KaiBLI/EasyDABv3/Images/EasyDAB v3 Rev.7 PCB Render-Front.png

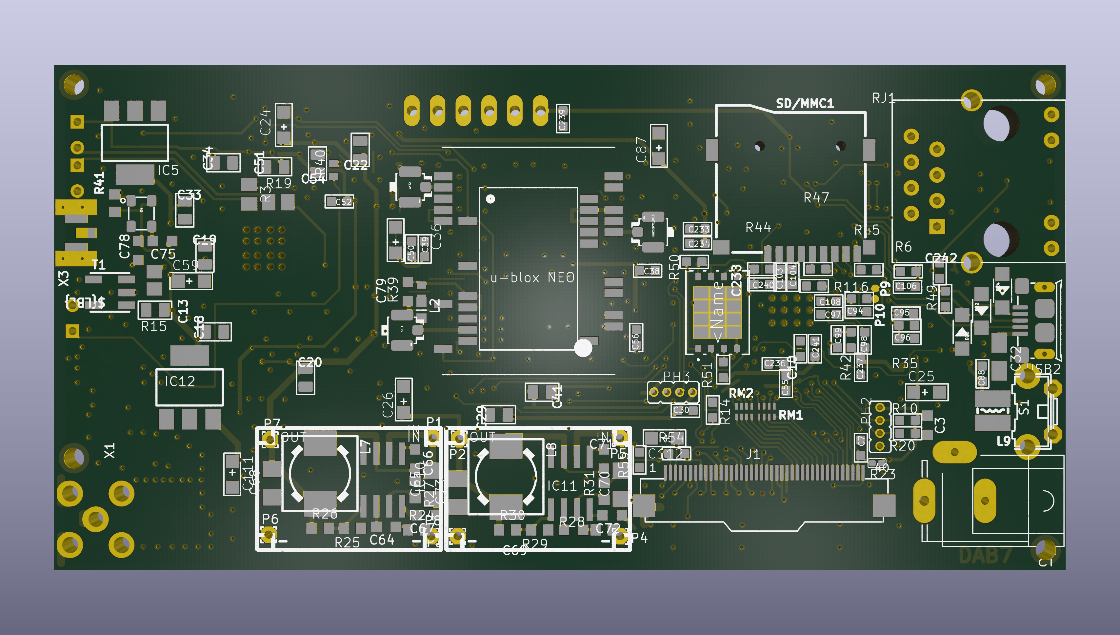
Images/EasyDAB v3 Rev.7 PCB Render-Front.png
