KaiBLI/EasyDABv3/easydabv3_big.jpg

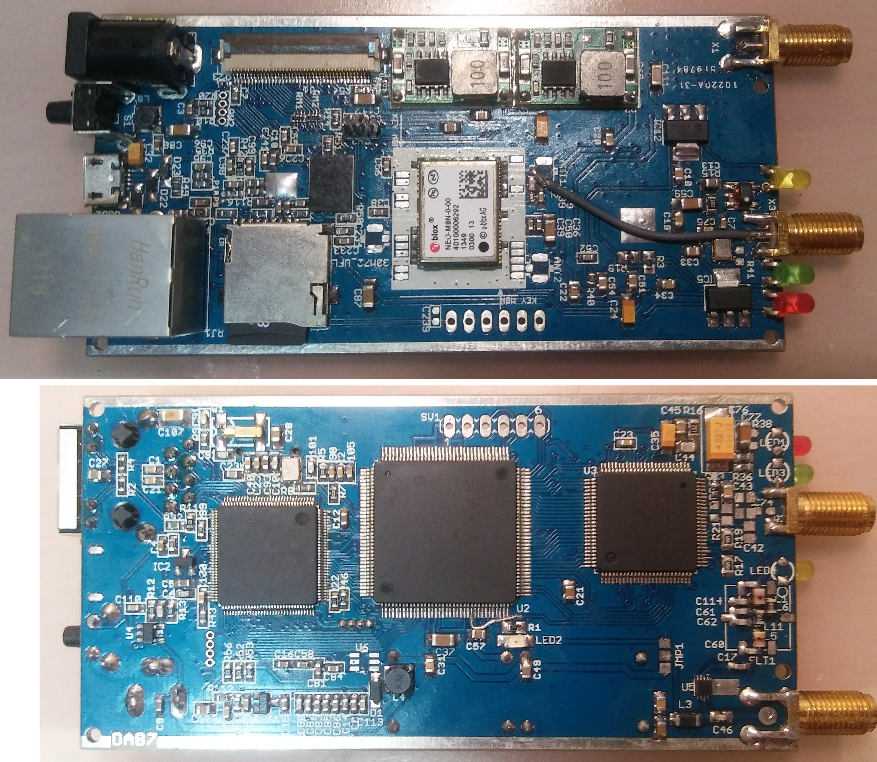
easydabv3_big.jpg
