KaiBLI/EasyDABv3/EagleBoard/V3s_LX9_AD9957_gps.brd

## EAGLE design EagleBoard/V3s_LX9_AD9957_gps.brd (2026-02-23)

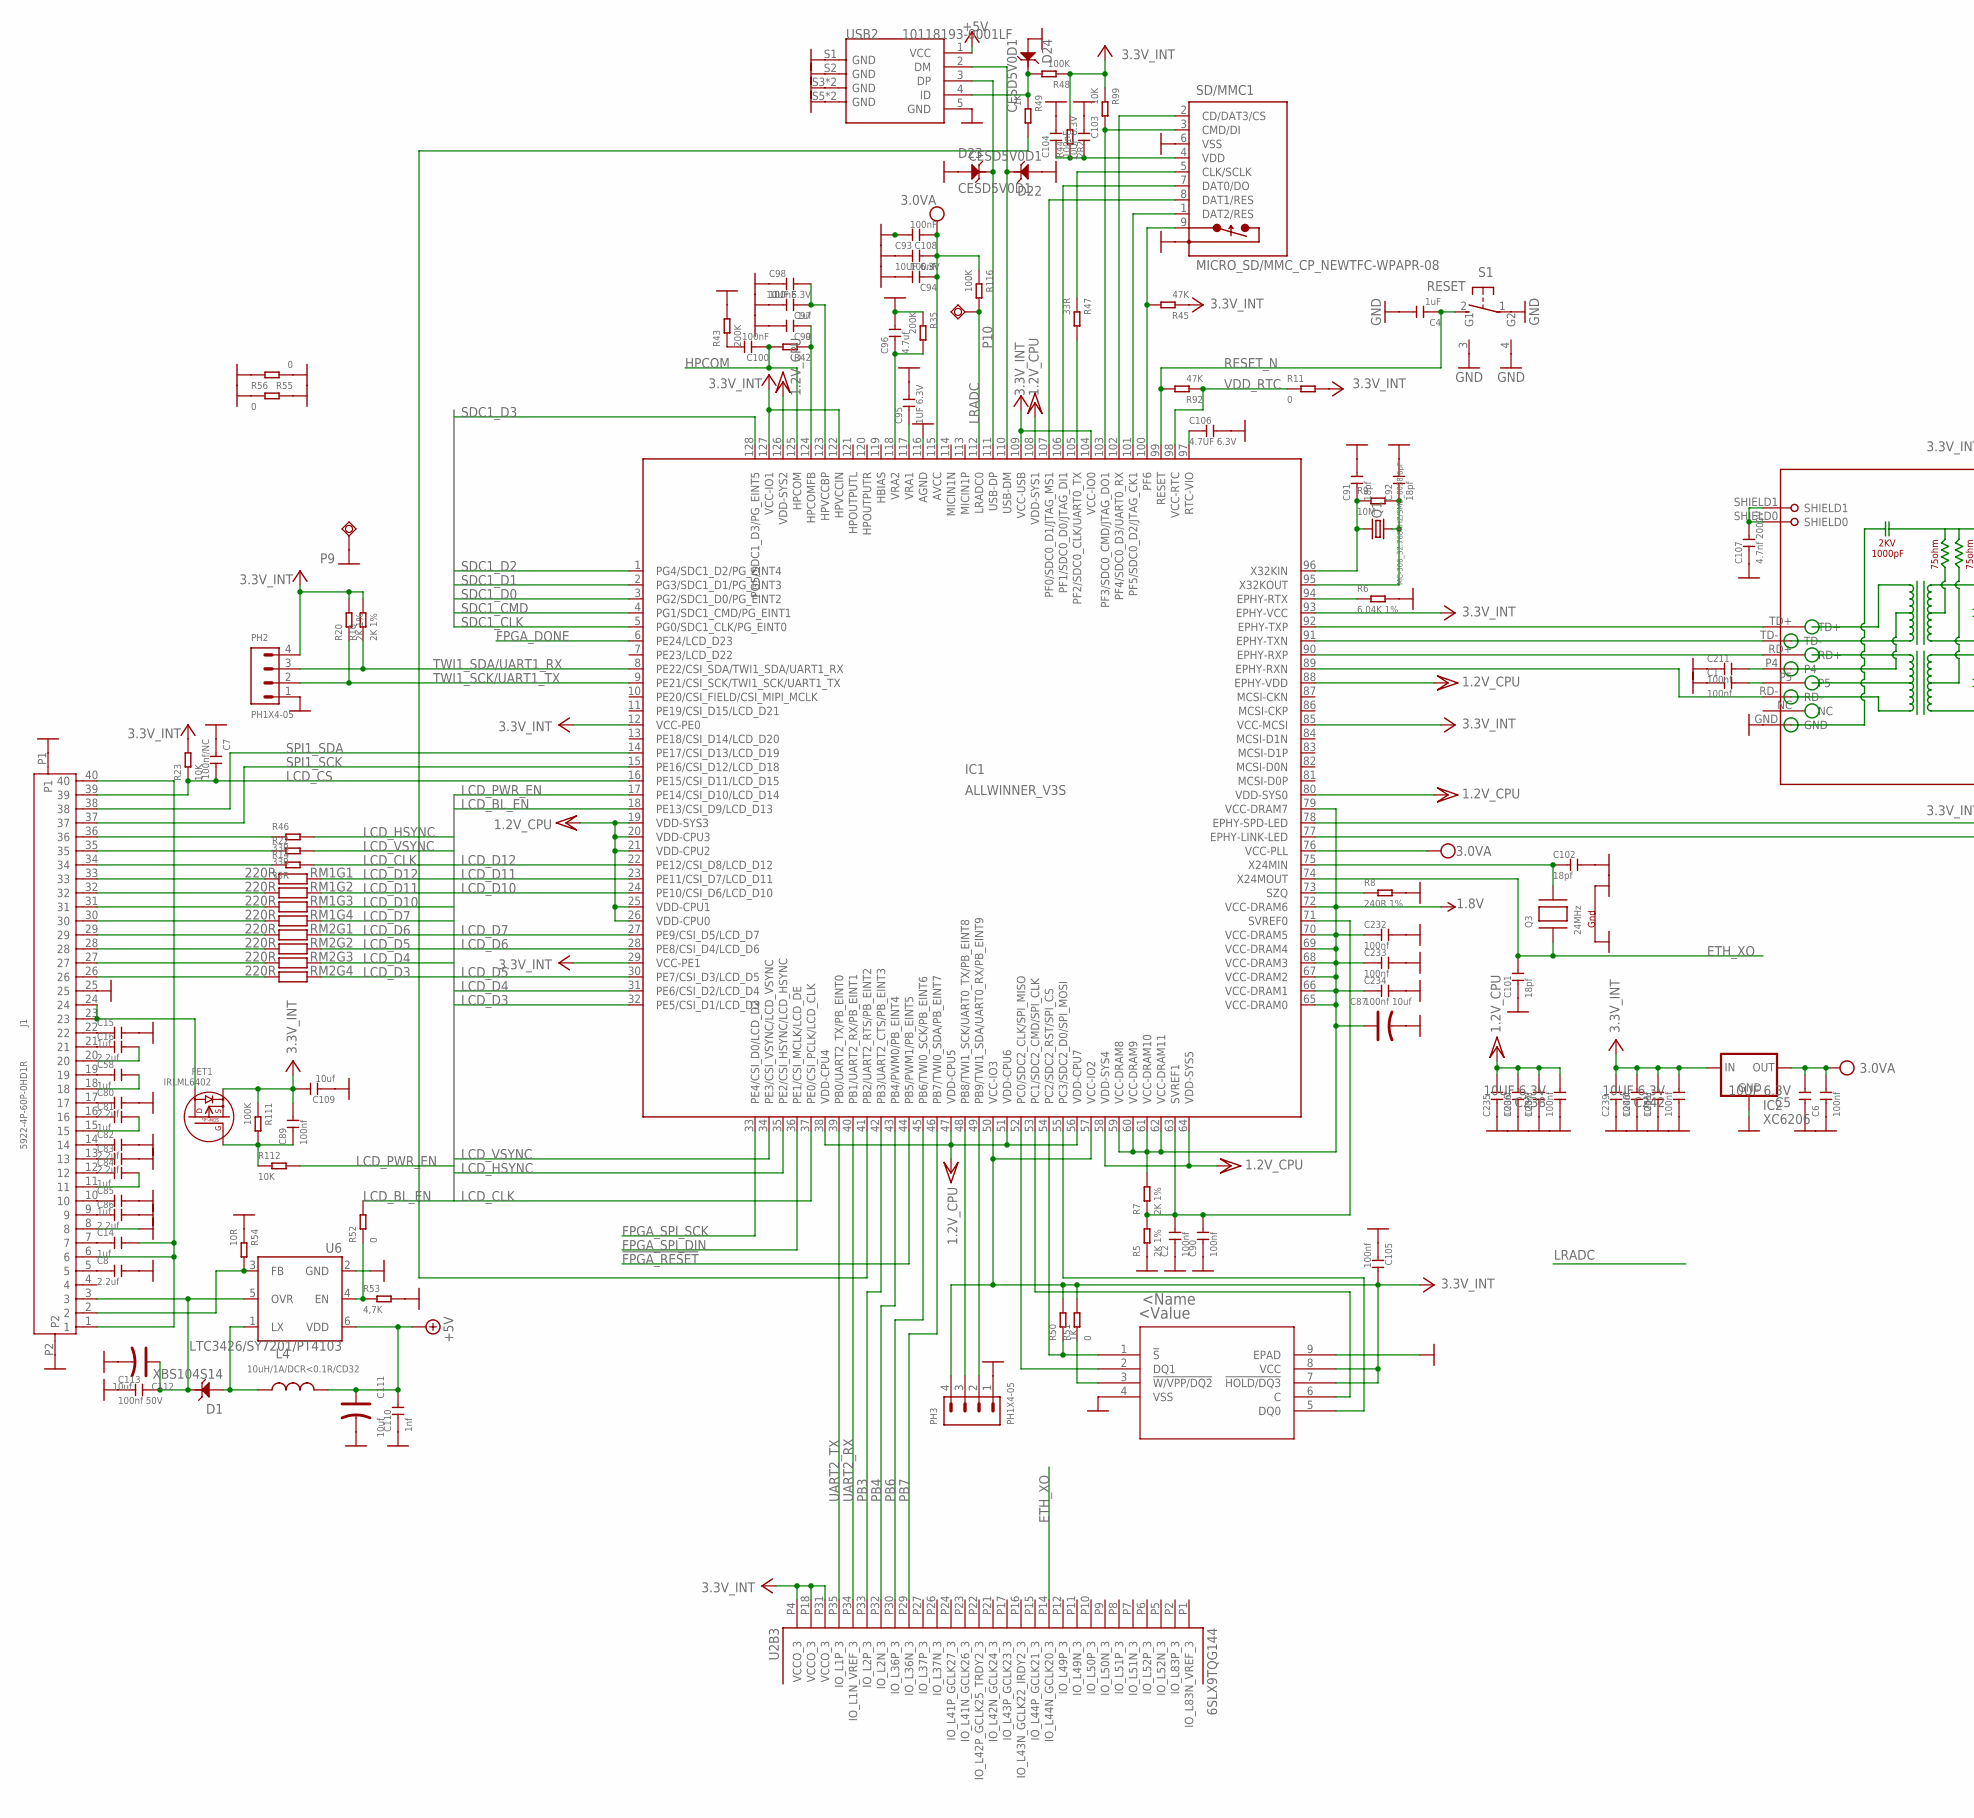
[picture p4: schematic V3s_LX9_AD9957_gps.sch, part in row 1, column 1]

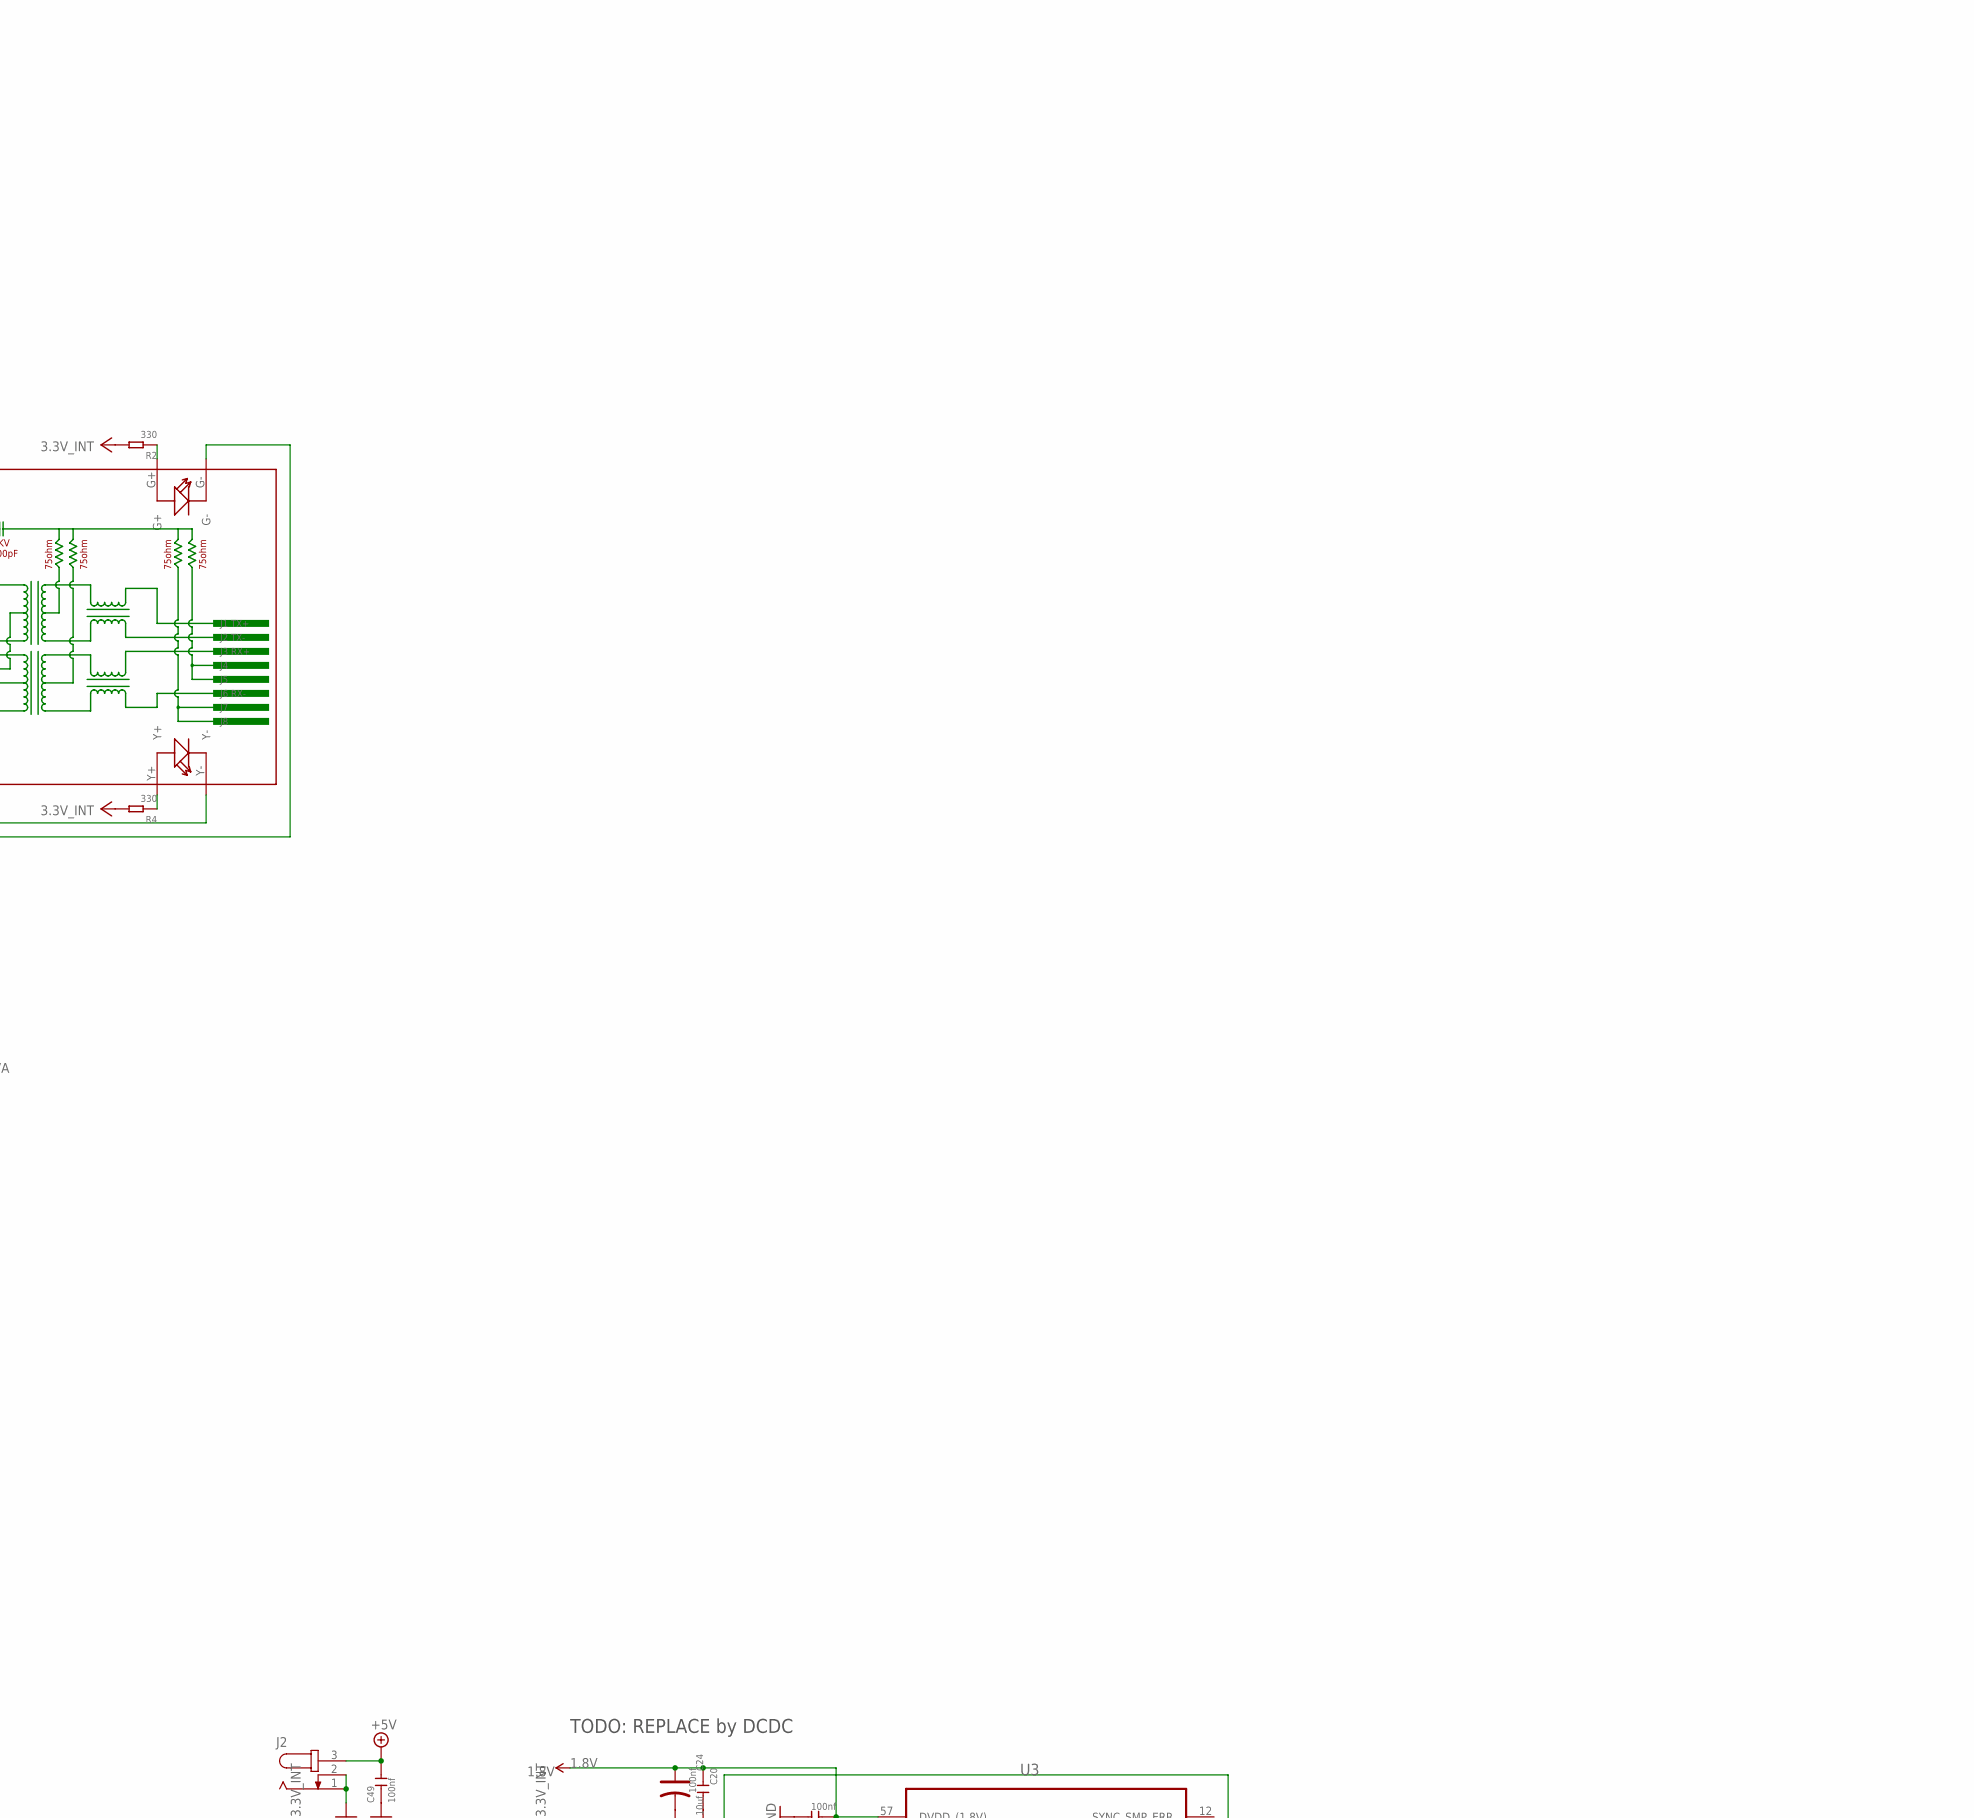
[picture p5: schematic V3s_LX9_AD9957_gps.sch, part in row 1, column 2]

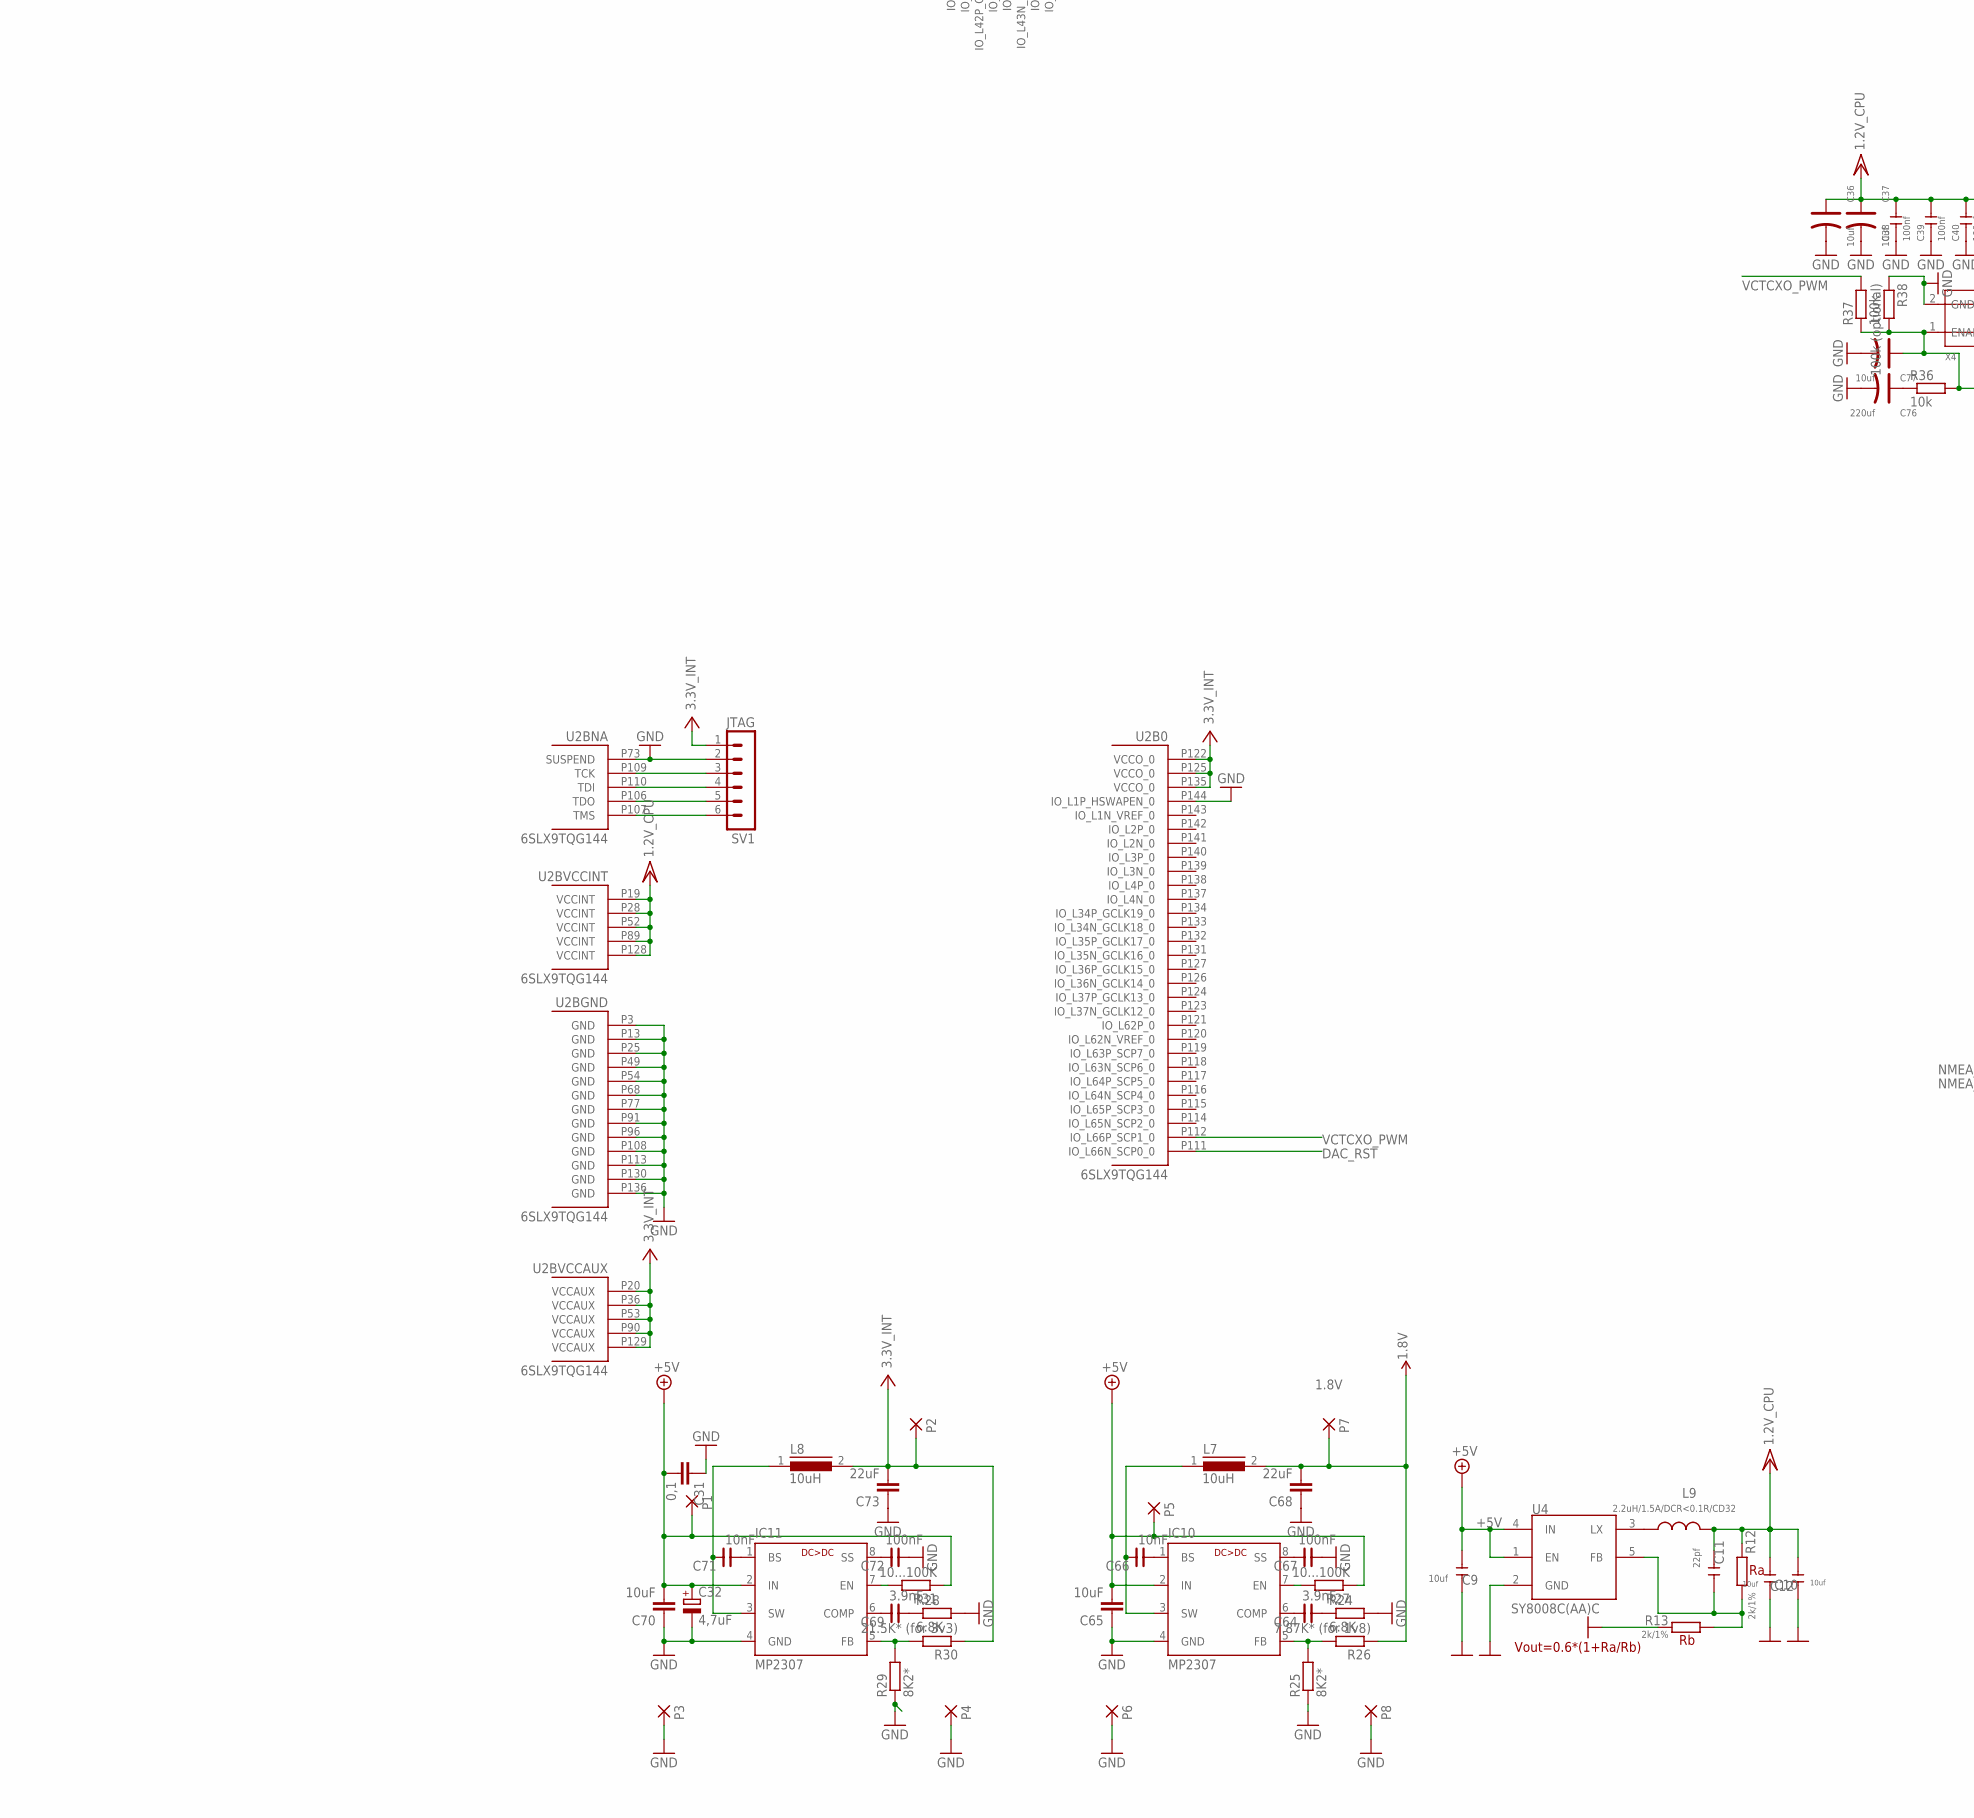
[picture p6: schematic V3s_LX9_AD9957_gps.sch, part in row 2, column 1]

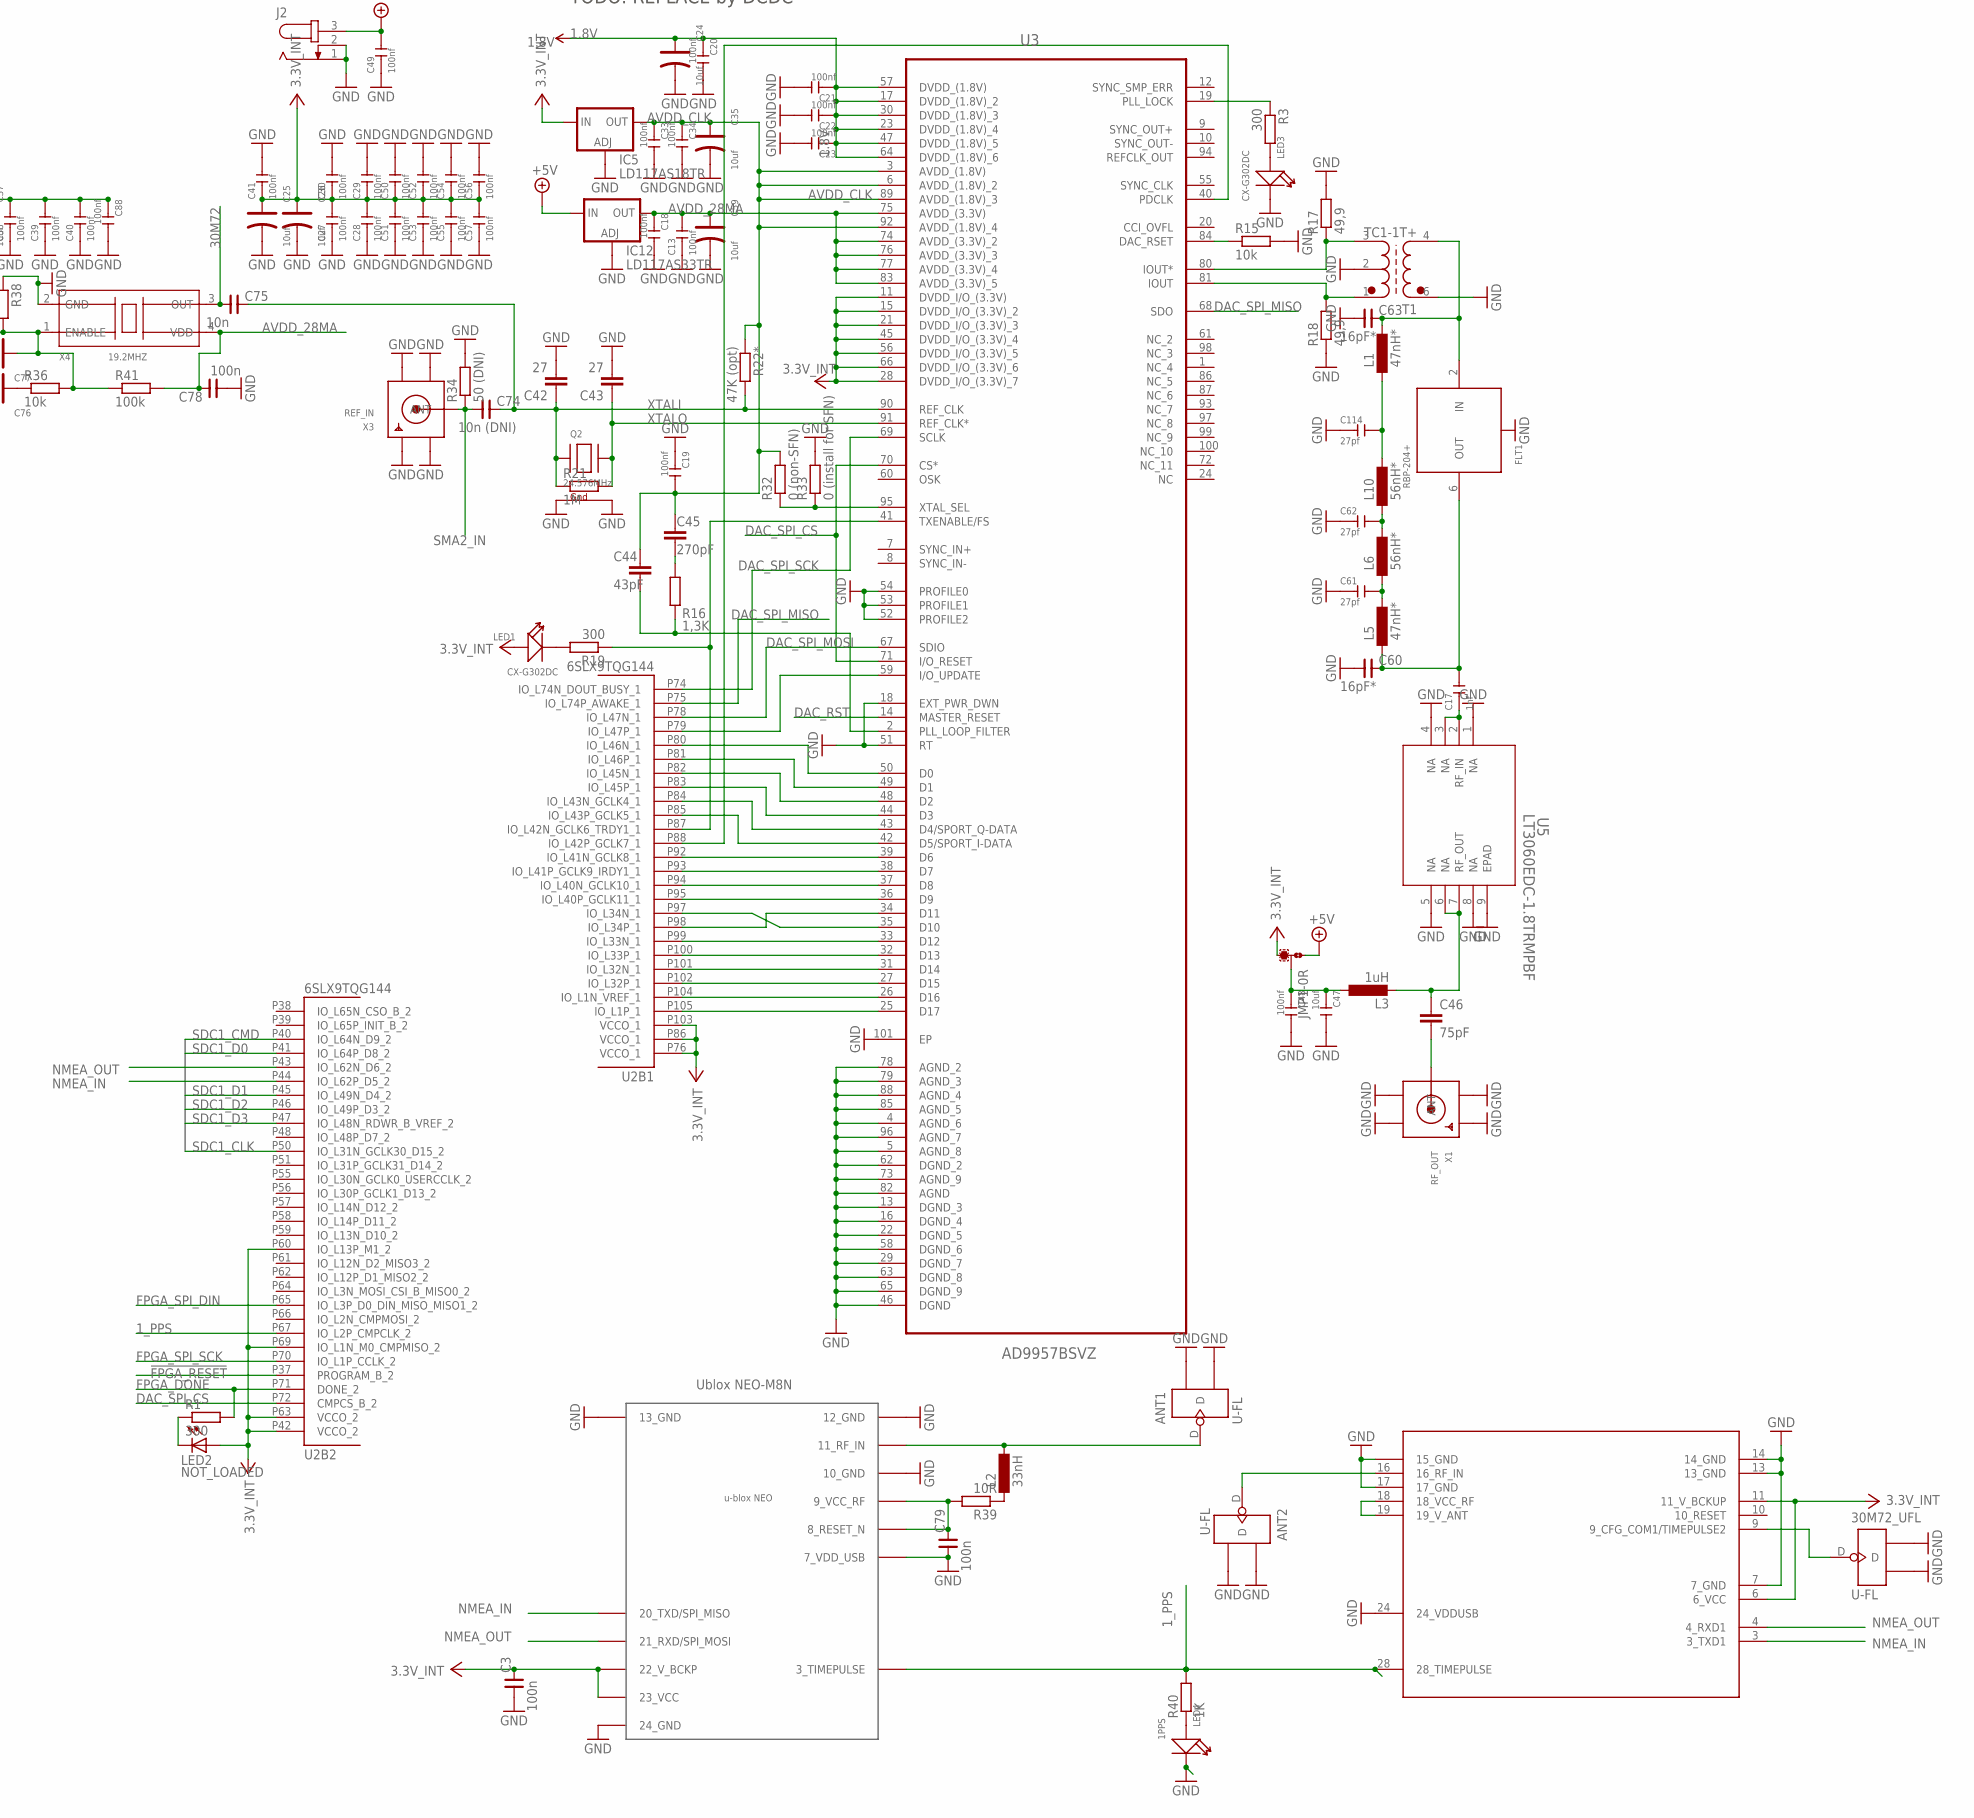
[picture p7: schematic V3s_LX9_AD9957_gps.sch, part in row 2, column 2]

Parts:
30M72_UFL: U-FL; U-FL3P-SMD-2.6X2.6X1.0MM
ANT1, ANT2: U-FL; U-FL3P-SMD-2.6X2.6X1.0MM
C1, C2, C6, C23, C30, C38, C39, C40, C50, C52, C53, C55, C56, C88, C89, C90, C105, C211, C232, C233, C234, C235, C236, C237, C239, C240, C241: 100nf; C0603
C3, C78, C79: 100n; 0603
C4: 1uF; C0603
C5, C93, C97, C103, C238, C242: 10UF 6.3V; C0603
C7: 100nf/NC; C0603
C8, C16, C80, C82, C83, C86: 2.2uf; C0603
C9, C10, C12: 10uf; C0603
C11: 22pf; C0603
C13, C18, C19, C20, C21, C22, C27, C28, C29, C33, C34, C41, C48, C49, C51, C54, C57: 100nf; C0805
C14, C15, C58, C81, C84, C85, C99: 1uf; C0603
C17, C110: 1nf; C0603
C24, C25, C26, C35, C36, C37, C59, C77, C87, C111, C112: 10uf; AVX-A
C31: 0,1; C0805
C32: 4,7uF; A/3216-18R
C42, C43: 27; C0805
C44: 43pF; C0805
C45: 270pF; C0805
C46: 75pF; C0805
C47, C109: 10uf; C0805
C60, C63: 16pF*; 0603
C61, C62, C114: 27pf; C0603
C64, C69: 3.9nF; 0603
C65, C70: 10uF; C1206
C66, C71: 10nF; 0603
C67, C72: 100nF; 0603
C68, C73: 22uF; C1206
C74: 10n (DNI); 0603
C75: 10n; 0603
C76: 220uf; AVX-D
C91, C92, C101, C102: 18pf; C0603
C94, C98, C100, C104, C108: 100nF; C0603
C95: 1UF 6.3V; C0603
C96: 4.7uf; C0603
C106: 4.7UF 6.3V; C0603
C107: 4.7nf 2000V; C1206
C113: 100nf 50V; C0603
D1: XBS104S14; SOD-123
D22, D23, D24: CESD5V0D1; SOD-123
FET1: IRLML6402; SOT23
FLT1: RBP-204+; GP731
IC1: ALLWINNER_V3S; ELQFP128
IC2: XC6206; SOT23
IC5: LD117AS18TR; SOT223
IC10, IC11: MP2307; SO8
IC12: LD117AS33TR; SOT223
J1: 5922-4P-60P-0HD1R; FPCE40-SMD-0.5-90D
J2: JACK-PLUG0; SPC4077
JMP1: 0R-JUMPA; A0R-JMP
L1, L5: 47nH*; INDC1608X95N
L2: 33nH; INDC1608X95N
L3: 1uH; L3216C
L4: 10uH/1A/DCR<0.1R/CD32; CD32
L6, L10: 56nH*; INDC1608X95N
L7, L8: 10uH; DR74
L9: 2.2uH/1.5A/DCR<0.1R/CD32; CD32
LED1, LED3: CX-G302DC; LED2-2.54-D3.0MM
LED2: NOT_LOADED; CHIPLED_1206
LED4: 1PPS; LED2-2.54-D3.0MM
P1, P2, P3, P4, P5, P6, P7, P8: 1,6/0,8
P9, P10: TESTPADTESTPAD30/30; TESTPAD_30-ROUND
PH2, PH3: PH1X4-05; PH005-1-4
Q1: MC-306_32.768KHZ/SMD_8038/6pF; MC-306
Q2: 24.576MHz; NX3225
Q3: 24MHz; NX3225
R1, R3, R19: 300; M0805
R2, R4: 330; R0603
R5, R7, R10, R20: 2K 1%; R0603
R6: 6.04K 1%; R0603
R8: 240R 1%; R0603
R9: 10M; R0603
R11, R42, R51, R52, R55, R56: 0; R0603
R12, R13: 2k/1%; R0603_5MIL_DWS
R14, R22, R46, R47: 33R; R0603
R15: 10k; R0805
R16: 1,3K; R0805
R17, R18: 49,9; R0805
R21: 1M; R0805
R22*: 47K (opt); R0603
R23: 10K; R0402
R24, R28: 6.8K; R0603
R25, R29: 8K2*; R0603
R26: 7.87K* (for 1v8); R0603
R27, R31: 10...100K; R0603
R30: 21.5K* (for 3v3); R0603
R32: 0 (non-SFN); R0402
R33: 0 (install for SFN); R0402
R34: 50 (DNI); R0402
R35, R43: 200K; R0603
R36: 10k; R0603
R37, R41: 100k; R0603
R38: 100k (optional); R0603
R39: 10R; R0402
R40: 1K; R0402
R44: 2R2; R0603
R45, R92: 47K; R0603
R48, R111, R116: 100K; R0603
R49, R50: 1K; R0603
R53: 4,7K; R0603
R54: 10R; R0603
R99, R112: 10K; R0603
RJ1: HR911105A
RM1, RM2: 220R; R_MATRIX_4_0402_25X625
S1: RESET; B3F-31XX
SD/MMC1: MICRO_SD/MMC_CP_NEWTFC-WPAPR-08; TFC-WPAPR-08
SV1: JTAG; MA06-1
T1: TC1-1T+; AT224-3
U1: N25Q256A13EF840EMIC; MIC-VFDFPN-8_8X6-M
U2: 6SLX9TQG144; TQ144
U3: AD9957BSVZ; QFP50P1600X1600X120-101N
U4: SY8008C(AA)C; SOT23-5
U5: LT3060EDC-1.8TRMPBF; DFN-8_DC
U6: LTC3426/SY7201/PT4103; SOT23-6
U10: NEO-M8
U11: UBLOX_LEA-6; UBLOX_LEA-6T
USB2: 10118193-0001LF; MICRO-USB5+6P-SMD-0.65-B
X1: RF_OUT; SMA90_DIP
X3: REF_IN; W5500_LX9_AD9957_SMA_EDGELAUNCH_UFL
X4: 19.2MHZ; X4-SMD-3.2X2.5X0.7MM

Connections:
1.8V: C20.1, C21.1, C22.1, C23.1, C24.+, C68.2, C87.+, C232.1, C233.1, C234.1, IC1.59 (VCC-DRAM8), IC1.60 (VCC-DRAM9), IC1.61 (VCC-DRAM10), IC1.62 (VCC-DRAM11), IC1.65 (VCC-DRAM0), IC1.66 (VCC-DRAM1), IC1.67 (VCC-DRAM2), IC1.68 (VCC-DRAM3), IC1.69 (VCC-DRAM4), IC1.70 (VCC-DRAM5), IC1.72 (VCC-DRAM6), IC1.79 (VCC-DRAM7), L7.2, P7.1, R7.2, R26.1, U3.17 (DVDD_(1.8V)_2), U3.23 (DVDD_(1.8V)_4), U3.30 (DVDD_(1.8V)_3), U3.47 (DVDD_(1.8V)_5), U3.57 (DVDD_(1.8V)), U3.64 (DVDD_(1.8V)_6)
1_PPS: R40.2, U2.P67 (IO_L2P_CMPCLK_2), U10.3 (3_TIMEPULSE), U11.28 (28_TIMEPULSE)
30M72: C75.1, X4.3 (OUT)
!FPGA_RESET: IC1.44 (PB5/PWM1/PB_EINT5), U2.P37 (PROGRAM_B_2)
+5V: C9.1, C31.2, C32.+, C49.2, C65.2, C70.2, C110.2, C111.+, IC10.2 (IN), IC11.2 (IN), IC12.3 (IN), J2.3, JMP1.1, L4.1, P1.1, P5.1, R27.1, R31.1, U4.1 (EN), U4.4 (IN), U6.6 (VDD), USB2.1 (VCC)
AVDD_28MA: C13.2, C18.1, C59.+, C78.2, IC12.4 (OUT), R41.2, U3.74 (AVDD_(3.3V)_2), U3.75 (AVDD_(3.3V)), U3.76 (AVDD_(3.3V)_3), U3.77 (AVDD_(3.3V)_4), U3.83 (AVDD_(3.3V)_5), X4.4 (VDD)
AVDD_CLK: C19.2, C33.1, C34.1, C35.+, C44.1, C45.1, IC5.4 (OUT), R22*.1, R32.2, U3.3 (AVDD_(1.8V)), U3.6 (AVDD_(1.8V)_2), U3.89 (AVDD_(1.8V)_3), U3.92 (AVDD_(1.8V)_4)
DAC_RST: U2.P111 (IO_L66N_SCP0_0), U3.14 (MASTER_RESET)
DAC_SPI_CS: U2.P72 (CMPCS_B_2), U3.70 (CS*), U3.71 (I/O_RESET)
DAC_SPI_MISO: U2.P75 (IO_L74P_AWAKE_1), U3.68 (SDO)
DAC_SPI_MOSI: U2.P78 (IO_L47N_1), U3.67 (SDIO)
DAC_SPI_SCK: U2.P74 (IO_L74N_DOUT_BUSY_1), U3.69 (SCLK)
ETH_XO: C101.2, IC1.74 (X24MOUT), Q3.1 (X1), U2.P14 (IO_L44N_GCLK20_3)
FPGA_DONE: IC1.6 (PE24/LCD_D23), R1.2, U2.P71 (DONE_2)
FPGA_SPI_DIN: IC1.36 (PE1/CSI_MCLK/LCD_DE), U2.P65 (IO_L3P_D0_DIN_MISO_MISO1_2)
FPGA_SPI_SCK: IC1.33 (PE4/CSI_D0/LCD_D2), U2.P70 (IO_L1P_CCLK_2)
GND: 30M72_UFL.GND1, 30M72_UFL.GND2, ANT1.GND1, ANT1.GND2, ANT2.GND1, ANT2.GND2, C1.1, C2.1, C3.1, C4.2, C5.1, C6.1, C7.1, C8.2, C9.2, C10.2, C12.2, C13.1, C15.2, C18.2, C19.1, C20.2, C21.2, C22.2, C23.2, C24.-, C25.-, C26.-, C27.1, C28.1, C29.2, C30.2, C31.1, C32.-, C33.2, C34.2, C35.-, C36.-, C37.-, C38.1, C39.1, C40.1, C41.2, C42.2, C43.2, C47.2, C48.2, C49.1, C50.2, C51.1, C52.2, C53.1, C54.2, C55.1, C56.2, C57.1, C59.-, C60.1, C61.1, C62.1, C63.1, C65.1, C67.1, C68.1, C70.1, C72.1, C73.1, C76.-, C77.-, C78.1, C79.1, C80.2, C82.2, C83.2, C85.2, C86.2, C87.-, C88.2, C90.1, C91.2, C92.2, C93.1, C94.2, C95.2, C96.2, C97.2, C98.1, C99.2, C101.1, C102.2, C103.1, C104.2, C105.1, C106.2, C107.1, C108.2, C109.1, C110.1, C111.-, C112.-, C113.1, C114.1, C211.1, C232.2, C233.2, C234.2, C235.1, C236.1, C237.1, C238.1, C239.1, C240.1, C241.1, C242.1, D22.+ (1), D23.+ (1), D24.+ (1), FLT1.1 (GND), FLT1.3 (GND), FLT1.4 (GND), FLT1.5 (GND), FLT1.7 (GND), FLT1.8 (GND), IC1.116 (AGND), IC2.1 (GND), IC5.1 (ADJ), IC10.4 (GND), IC11.4 (GND), IC12.1 (ADJ), J1.8, J1.25, J1.P1, J1.P2, J2.1, J2.2, LED3.K (-), LED4.K (-), P3.1, P4.1, P6.1, P8.1, P9.1, PH2.1, PH3.1, Q2.2 (G2), Q2.4 (G1), Q3.2 (G2), Q3.4 (G1), R5.1, R6.2, R8.2, R13.2, R15.2, R17.2, R18.1, R24.2, R25.1, R28.2, R29.1, R33.2, R34.2, R35.1, R38.1, R43.2, R53.2, R54.1, R55.1, R55.2, R56.1, R56.2, RJ1.GND, S1.1, S1.3 (G1), S1.4 (G2), SD/MMC1.6 (VSS), SD/MMC1.10 (PACK1), SV1.2, T1.2 (SCT), T1.6 (PD), U1.4 (VSS), U1.9 (EPAD), U2.P3 (GND), U2.P13 (GND), U2.P25 (GND), U2.P49 (GND), U2.P54 (GND), U2.P68 (GND), U2.P73 (SUSPEND), U2.P77 (GND), U2.P91 (GND), U2.P96 (GND), U2.P108 (GND), U2.P113 (GND), U2.P130 (GND), U2.P136 (GND), U2.P144 (IO_L1P_HSWAPEN_0), U3.4 (AGND_6), U3.5 (AGND_8), U3.13 (DGND_3), U3.16 (DGND_4), U3.18 (EXT_PWR_DWN), U3.22 (DGND_5), U3.29 (DGND_7), U3.46 (DGND), U3.51 (RT), U3.52 (PROFILE2), U3.53 (PROFILE1), U3.54 (PROFILE0), U3.58 (DGND_6), U3.62 (DGND_2), U3.63 (DGND_8), U3.65 (DGND_9), U3.73 (AGND_9), U3.78 (AGND_2), U3.79 (AGND_3), U3.82 (AGND), U3.85 (AGND_5), U3.88 (AGND_4), U3.96 (AGND_7), U3.101 (EP), U4.2 (GND), U5.1 (NA), U5.4 (NA), U5.5 (NA), U5.8 (NA), U5.9 (EPAD), U6.2 (GND), U10.7 (7_VDD_USB), U10.10 (10_GND), U10.12 (12_GND), U10.13 (13_GND), U10.24 (24_GND), U11.7 (7_GND), U11.13 (13_GND), U11.14 (14_GND), U11.15 (15_GND), U11.17 (17_GND), U11.24 (24_VDDUSB), USB2.5 (GND), USB2.S1 (GND), USB2.S2 (GND), USB2.S3 (GND), USB2.S4 (GND), USB2.S5 (GND), USB2.S6 (GND), X1.GND1, X1.GND2, X1.GND3, X1.GND4, X3.GND@1 (GND1), X3.GND@2 (GND2), X3.GND@3 (GND3), X3.GND@4 (GND4), X4.2 (GND)
GPSDO_OUT_30M72: 30M72_UFL.D, U11.9 (9_CFG_COM1/TIMEPULSE2)
HPCOM: C100.1, IC1.125 (HPCOM), R42.2
LCD_BL_EN: IC1.18 (PE13/CSI_D9/LCD_D13), R52.2
LCD_CLK: IC1.37 (PE0/CSI_PCLK/LCD_CLK), R14.2
LCD_CS: C7.2, IC1.16 (PE15/CSI_D11/LCD_D15), J1.39, R23.1
LCD_D3: IC1.32 (PE5/CSI_D1/LCD_D3), RM2.4.1 (1)
LCD_D4: IC1.31 (PE6/CSI_D2/LCD_D4), RM2.3.1 (1)
LCD_D5: IC1.30 (PE7/CSI_D3/LCD_D5), RM2.2.1 (1)
LCD_D6: IC1.28 (PE8/CSI_D4/LCD_D6), RM2.1.1 (1)
LCD_D7: IC1.27 (PE9/CSI_D5/LCD_D7), RM1.4.1 (1)
LCD_D10: IC1.24 (PE10/CSI_D6/LCD_D10), RM1.3.1 (1)
LCD_D11: IC1.23 (PE11/CSI_D7/LCD_D11), RM1.2.1 (1)
LCD_D12: IC1.22 (PE12/CSI_D8/LCD_D12), RM1.1.1 (1)
LCD_HSYNC: IC1.35 (PE2/CSI_HSYNC/LCD_HSYNC), R46.2
LCD_PWR_EN: IC1.17 (PE14/CSI_D10/LCD_D14), R112.2
LCD_VSYNC: IC1.34 (PE3/CSI_VSYNC/LCD_VSYNC), R22.2
LRADC: IC1.112 (LRADC0), P10.1, R116.2
unnamed: SV1.6, U2.P107 (TMS)
unnamed: SV1.5, U2.P106 (TDO)
unnamed: SV1.4, U2.P110 (TDI)
unnamed: SV1.3, U2.P109 (TCK)
unnamed: LED2.C, R1.1
unnamed: C62.2, L6.2, L10.1
unnamed: U2.P105 (IO_L1P_1), U3.25 (D17)
unnamed: C14.2, J1.1, J1.6, J1.40
unnamed: U2.P88 (IO_L42P_GCLK7_1), U3.40 (PDCLK)
unnamed: R19.1, U2.P87 (IO_L42N_GCLK6_TRDY1_1), U3.41 (TXENABLE/FS)
unnamed: U2.P85 (IO_L43P_GCLK5_1), U3.42 (D5/SPORT_I-DATA)
unnamed: U2.P84 (IO_L43N_GCLK4_1), U3.43 (D4/SPORT_Q-DATA)
unnamed: U2.P83 (IO_L45P_1), U3.44 (D3)
unnamed: U2.P82 (IO_L45N_1), U3.48 (D2)
unnamed: U2.P92 (IO_L41N_GCLK8_1), U3.39 (D6)
unnamed: U2.P93 (IO_L41P_GCLK9_IRDY1_1), U3.38 (D7)
unnamed: U2.P94 (IO_L40N_GCLK10_1), U3.37 (D8)
unnamed: U2.P95 (IO_L40P_GCLK11_1), U3.36 (D9)
unnamed: U2.P98 (IO_L34P_1), U3.34 (D11)
unnamed: U2.P97 (IO_L34N_1), U3.35 (D10)
unnamed: U2.P99 (IO_L33N_1), U3.33 (D12)
unnamed: U2.P100 (IO_L33P_1), U3.32 (D13)
unnamed: U2.P101 (IO_L32N_1), U3.31 (D14)
unnamed: U2.P102 (IO_L32P_1), U3.27 (D15)
unnamed: U2.P104 (IO_L1N_VREF_1), U3.26 (D16)
unnamed: U2.P79 (IO_L47P_1), U3.59 (I/O_UPDATE)
unnamed: C14.1, J1.7
unnamed: U2.P81 (IO_L46P_1), U3.49 (D1)
unnamed: LED3.A (+), R3.2
unnamed: R3.1, U3.19 (PLL_LOCK)
unnamed: R15.1, U3.84 (DAC_RSET)
unnamed: R17.1, T1.3 (S), U3.80 (IOUT*)
unnamed: R18.2, T1.1 (SD), U3.81 (IOUT)
unnamed: C63.2, FLT1.2 (IN), L1.2, T1.4
unnamed: U2.P80 (IO_L46N_1), U3.50 (D0)
unnamed: IC1.89 (EPHY-RXN), RJ1.RD-
unnamed: C211.2, RJ1.P4
unnamed: IC1.94 (EPHY-RTX), R6.1
unnamed: IC1.78 (EPHY-SPD-LED), RJ1.Y-
unnamed: IC1.77 (EPHY-LINK-LED), RJ1.G-
unnamed: R4.1, RJ1.Y+
unnamed: R2.1, RJ1.G+
unnamed: C2.2, C90.2, IC1.63 (SVREF1), IC1.71 (SVREF0), R5.2, R7.1
unnamed: IC1.73 (SZQ), R8.1
unnamed: C92.1, IC1.95 (X32KOUT), Q1.1, R9.2
unnamed: C91.1, IC1.96 (X32KIN), Q1.4 (2), R9.1
unnamed: D22.- (2), IC1.110 (USB-DM), USB2.2 (DM)
unnamed: D23.- (2), IC1.111 (USB-DP), USB2.3 (DP)
unnamed: C95.1, IC1.117 (VRA1)
unnamed: C96.1, IC1.118 (VRA2), R35.2
unnamed: C99.1, IC1.124 (HPCOMFB), R42.1
unnamed: C102.1, IC1.75 (X24MIN), Q3.3 (X2)
unnamed: U11.18 (18_VCC_RF), U11.19 (19_V_ANT)
unnamed: IC1.107 (PF0/SDC0_D1/JTAG_MS1), SD/MMC1.8 (DAT1/RES)
unnamed: IC1.106 (PF1/SDC0_D0/JTAG_DI1), SD/MMC1.7 (DAT0/DO)
unnamed: R47.1, SD/MMC1.5 (CLK/SCLK)
unnamed: IC1.103 (PF3/SDC0_CMD/JTAG_DO1), R99.2, SD/MMC1.3 (CMD/DI)
unnamed: IC1.102 (PF4/SDC0_D3/UART0_RX), SD/MMC1.2 (CD/DAT3/CS)
unnamed: IC1.101 (PF5/SDC0_D2/JTAG_CK1), SD/MMC1.1 (DAT2/RES)
unnamed: IC1.100 (PF6), R45.2, SD/MMC1.9 (CP_E)
unnamed: ANT1.D, L2.2, U10.11 (11_RF_IN)
unnamed: IC1.105 (PF2/SDC0_CLK/UART0_TX), R47.2
unnamed: D24.- (2), R48.2, R49.1, USB2.4 (ID)
unnamed: IC1.41 (PB2/UART2_RTS/PB_EINT2), R49.2
unnamed: IC1.92 (EPHY-TXP), RJ1.TD+
unnamed: IC1.91 (EPHY-TXN), RJ1.TD-
unnamed: IC1.90 (EPHY-RXP), RJ1.RD+
unnamed: L9.1, U4.3 (LX)
unnamed: C97.1, C98.2, IC1.123 (HPVCCBP)
unnamed: C8.1, J1.5
unnamed: R51.1, U1.3 (!W/VPP/DQ2)
unnamed: C11.2, R12.2, R13.1, U4.5 (FB)
unnamed: J1.33, RM1.1.2 (2)
unnamed: ANT2.D, U11.16 (16_RF_IN)
unnamed: C114.2, L1.1, L10.2
unnamed: C44.2, R16.2, U3.2 (PLL_LOOP_FILTER)
unnamed: J1.36, R46.1
unnamed: J1.35, R22.1
unnamed: J1.34, R14.1
unnamed: J1.32, RM1.2.2 (2)
unnamed: J1.31, RM1.3.2 (2)
unnamed: J1.30, RM1.4.2 (2)
unnamed: C45.2, R16.1
unnamed: C17.2, C60.2, FLT1.6 (OUT), L5.1
unnamed: J1.29, RM2.1.2 (2)
unnamed: C46.1, L3.2, U5.6 (NA), U5.7 (RF_OUT)
unnamed: C46.2, X1.ANTENNA (ANT)
unnamed: C47.1, C48.1, JMP1.2, L3.1
unnamed: LED1.K (-), R19.2
unnamed: L2.1, R39.1
unnamed: C61.2, L5.2, L6.1
unnamed: J1.28, RM2.2.2 (2)
unnamed: C79.2, R39.2, U10.8 (8_RESET_N), U10.9 (9_VCC_RF)
unnamed: LED4.A (+), R40.1
unnamed: J1.27, RM2.3.2 (2)
unnamed: J1.26, RM2.4.2 (2)
unnamed: C15.1, J1.22
unnamed: C17.1, U5.2 (RF_IN), U5.3 (NA)
unnamed: C64.2, IC10.6 (COMP)
unnamed: C64.1, R24.1
unnamed: C66.1, IC10.1 (BS)
unnamed: C66.2, IC10.3 (SW), L7.1
unnamed: C67.2, IC10.8 (SS)
unnamed: IC10.5 (FB), R25.2, R26.2
unnamed: R32.1, R33.1, U3.95 (XTAL_SEL)
unnamed: IC10.7 (EN), R27.2
unnamed: C100.2, R43.1
unnamed: C69.1, R28.1
unnamed: C69.2, IC11.6 (COMP)
unnamed: C71.1, IC11.1 (BS)
unnamed: C71.2, IC11.3 (SW), L8.1
unnamed: C72.2, IC11.8 (SS)
unnamed: IC11.5 (FB), R29.2, R30.2
unnamed: C103.2, C104.1, R44.1, SD/MMC1.4 (VDD)
unnamed: IC11.7 (EN), R31.2
unnamed: C76.+, R36.1
unnamed: C77.+, R36.2, R37.1, R38.2, R41.1, X4.1 (ENABLE)
unnamed: C16.1, J1.21
unnamed: C16.2, J1.20
unnamed: C58.1, J1.19
unnamed: C58.2, J1.18
unnamed: C80.1, J1.17
unnamed: C81.1, J1.16
unnamed: C81.2, J1.15
unnamed: C82.1, J1.14
unnamed: C83.1, J1.13
unnamed: C84.1, J1.12
unnamed: C84.2, J1.11
unnamed: C85.1, J1.10
unnamed: C86.1, J1.9
unnamed: R52.1, R53.1, U6.4 (EN)
unnamed: D1.+ (1), L4.2, U6.1 (LX)
unnamed: J1.2, R54.2, U6.3 (FB)
unnamed: C112.+, C113.2, D1.- (2), J1.3, U6.5 (OVR)
unnamed: IC1.48 (PB8/TWI1_SCK/UART0_TX/PB_EINT8), PH3.3
unnamed: IC1.49 (PB9/TWI1_SDA/UART0_RX/PB_EINT9), PH3.2
unnamed: IC1.54 (PC2/SDC2_RST/SPI_CS), R50.1, U1.1 (!S)
unnamed: IC1.52 (PC0/SDC2_CLK/SPI_MISO), U1.2 (DQ1)
unnamed: IC1.53 (PC1/SDC2_CMD/SPI_CLK), U1.6 (C)
unnamed: IC1.55 (PC3/SDC2_D0/SPI_MOSI), U1.5 (DQ0)
unnamed: C106.1, IC1.97 (RTC-VIO)
unnamed: C107.2, RJ1.SHIELD0, RJ1.SHIELD1
unnamed: FET1.3 (D), J1.23, J1.24
unnamed: C89.1, FET1.1 (G), R111.2, R112.1
unnamed: C1.2, RJ1.P5
NMEA_IN: U2.P44 (IO_L62P_D5_2), U10.20 (20_TXD/SPI_MISO), U11.3 (3_TXD1)
NMEA_OUT: U2.P43 (IO_L62N_D6_2), U10.21 (21_RXD/SPI_MOSI), U11.4 (4_RXD1)
PB3: IC1.42 (PB3/UART2_CTS/PB_EINT3), U2.P33 (IO_L2P_3)
PB4: IC1.43 (PB4/PWM0/PB_EINT4), U2.P32 (IO_L2N_3)
PB6: IC1.45 (PB6/TWI0_SCK/PB_EINT6), U2.P30 (IO_L36P_3)
PB7: IC1.46 (PB7/TWI0_SDA/PB_EINT7), U2.P29 (IO_L36N_3)
RESET_N: C4.1, IC1.99 (RESET), R92.2, S1.2 (S)
SDC1_CLK: IC1.5 (PG0/SDC1_CLK/PG_EINT0), U2.P50 (IO_L31N_GCLK30_D15_2)
SDC1_CMD: IC1.4 (PG1/SDC1_CMD/PG_EINT1), U2.P40 (IO_L64N_D9_2)
SDC1_D0: IC1.3 (PG2/SDC1_D0/PG_EINT2), U2.P41 (IO_L64P_D8_2)
SDC1_D1: IC1.2 (PG3/SDC1_D1/PG_EINT3), U2.P45 (IO_L49N_D4_2)
SDC1_D2: IC1.1 (PG4/SDC1_D2/PG_EINT4), U2.P46 (IO_L49P_D3_2)
SDC1_D3: IC1.128 (PG5/SDC1_D3/PG_EINT5), U2.P47 (IO_L48N_RDWR_B_VREF_2)
SMA2_IN: C74.1, R34.1, X3.P (ANT)
SPI1_SCK: IC1.15 (PE16/CSI_D12/LCD_D18), J1.37
SPI1_SDA: IC1.14 (PE17/CSI_D13/LCD_D19), J1.38
TWI1_SCK/UART1_TX: IC1.9 (PE21/CSI_SCK/TWI1_SCK/UART1_TX), PH2.2, R20.1
TWI1_SDA/UART1_RX: IC1.8 (PE22/CSI_SDA/TWI1_SDA/UART1_RX), PH2.3, R10.1
UART2_RX: IC1.40 (PB1/UART2_RX/PB_EINT1), U2.P34 (IO_L1N_VREF_3)
UART2_TX: IC1.39 (PB0/UART2_TX/PB_EINT0), U2.P35 (IO_L1P_3)
VCC/2: C10.1, C11.1, C12.1, C36.+, C37.+, C38.2, C39.2, C40.2, C88.1, C235.2, C236.2, C237.2, C238.2, IC1.19 (VDD-SYS3), IC1.20 (VDD-CPU3), IC1.21 (VDD-CPU2), IC1.25 (VDD-CPU1), IC1.26 (VDD-CPU0), IC1.38 (VDD-CPU4), IC1.47 (VDD-CPU5), IC1.51 (VDD-CPU6), IC1.56 (VDD-CPU7), IC1.58 (VDD-SYS4), IC1.64 (VDD-SYS5), IC1.80 (VDD-SYS0), IC1.88 (EPHY-VDD), IC1.108 (VDD-SYS1), IC1.126 (VDD-SYS2), L9.2, R12.1, U2.P19 (VCCINT), U2.P28 (VCCINT), U2.P52 (VCCINT), U2.P89 (VCCINT), U2.P128 (VCCINT)
VCCINT: C3.2, C25.+, C26.+, C27.2, C28.2, C29.1, C30.1, C41.1, C50.1, C51.2, C52.1, C53.2, C54.1, C55.2, C56.1, C57.2, C73.2, C89.2, C105.2, C109.2, C239.2, C240.2, C241.2, C242.2, FET1.2 (S), IC1.12 (VCC-PE0), IC1.29 (VCC-PE1), IC1.50 (VCC-IO3), IC1.57 (VCC-IO2), IC1.85 (VCC-MCSI), IC1.93 (EPHY-VCC), IC1.104 (VCC-IO0), IC1.109 (VCC-USB), IC1.122 (HPVCCIN), IC1.127 (VCC-IO1), IC2.3 (IN), IC5.3 (IN), JMP1.3, L8.2, LED1.A (+), LED2.A, P2.1, PH2.4, PH3.4, R2.2, R4.2, R10.2, R11.2, R20.2, R23.2, R30.1, R44.2, R45.1, R48.1, R50.2, R51.2, R99.1, R111.1, SV1.1, U1.7 (!HOLD/DQ3), U1.8 (VCC), U2.P4 (VCCO_3), U2.P18 (VCCO_3), U2.P20 (VCCAUX), U2.P31 (VCCO_3), U2.P36 (VCCAUX), U2.P42 (VCCO_2), U2.P53 (VCCAUX), U2.P60 (IO_L13P_M1_2), U2.P63 (VCCO_2), U2.P69 (IO_L1N_M0_CMPMISO_2), U2.P76 (VCCO_1), U2.P86 (VCCO_1), U2.P90 (VCCAUX), U2.P103 (VCCO_1), U2.P122 (VCCO_0), U2.P125 (VCCO_0), U2.P129 (VCCAUX), U2.P135 (VCCO_0), U3.11 (DVDD_I/O_(3.3V)), U3.15 (DVDD_I/O_(3.3V)_2), U3.21 (DVDD_I/O_(3.3V)_3), U3.28 (DVDD_I/O_(3.3V)_7), U3.45 (DVDD_I/O_(3.3V)_4), U3.56 (DVDD_I/O_(3.3V)_5), U3.66 (DVDD_I/O_(3.3V)_6), U10.22 (22_V_BCKP), U10.23 (23_VCC), U11.6 (6_VCC), U11.11 (11_V_BCKUP)
VCTCXO_PWM: R37.2, U2.P112 (IO_L66P_SCP1_0)
VDD_RTC: IC1.98 (VCC-RTC), R11.1, R92.1
VPP: C5.2, C6.2, C93.2, C94.1, C108.1, IC1.76 (VCC-PLL), IC1.115 (AVCC), IC2.2 (OUT), R116.1
XTALI: C42.1, C74.2, C75.2, Q2.1 (X1), R21.1, R22*.2, U3.90 (REF_CLK)
XTALO: C43.1, Q2.3 (X2), R21.2, U3.91 (REF_CLK*)

Notes on the sheet:
TODO: REPLACE by DCDC
Ublox NEO-M8N
Vout=0.6*(1+Ra/Rb)

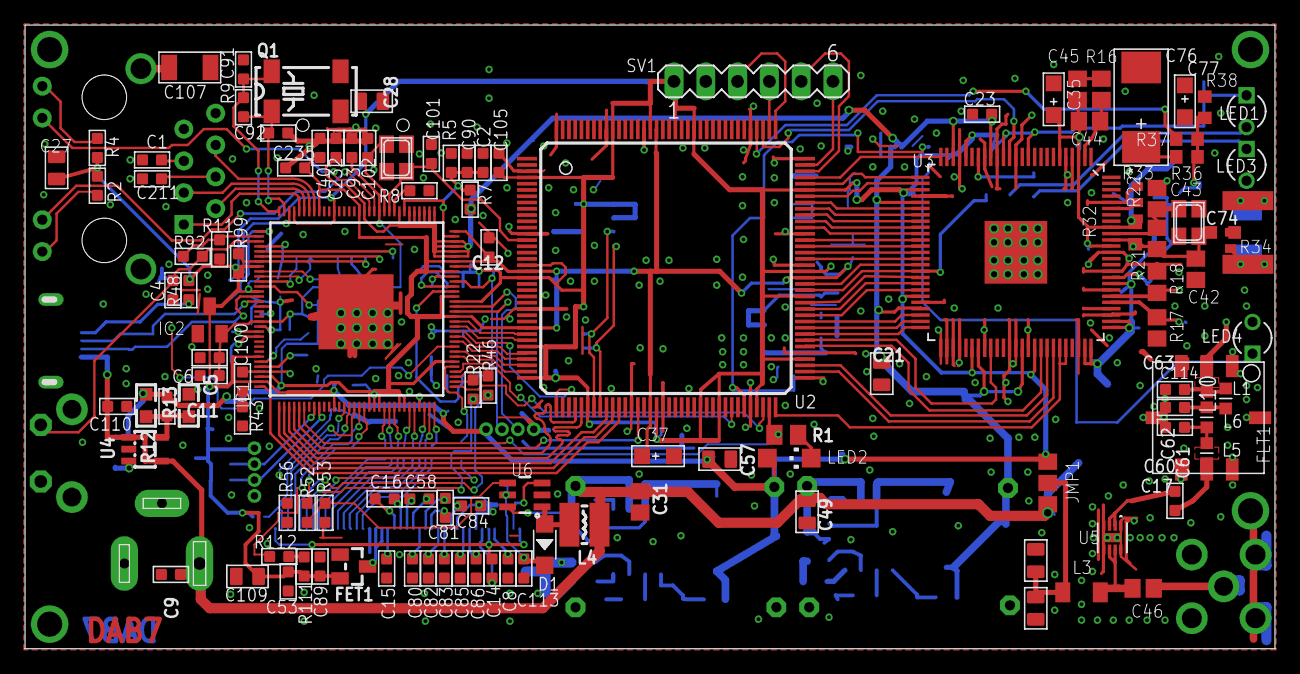
[picture p8: board V3s_LX9_AD9957_gps.brd from above]

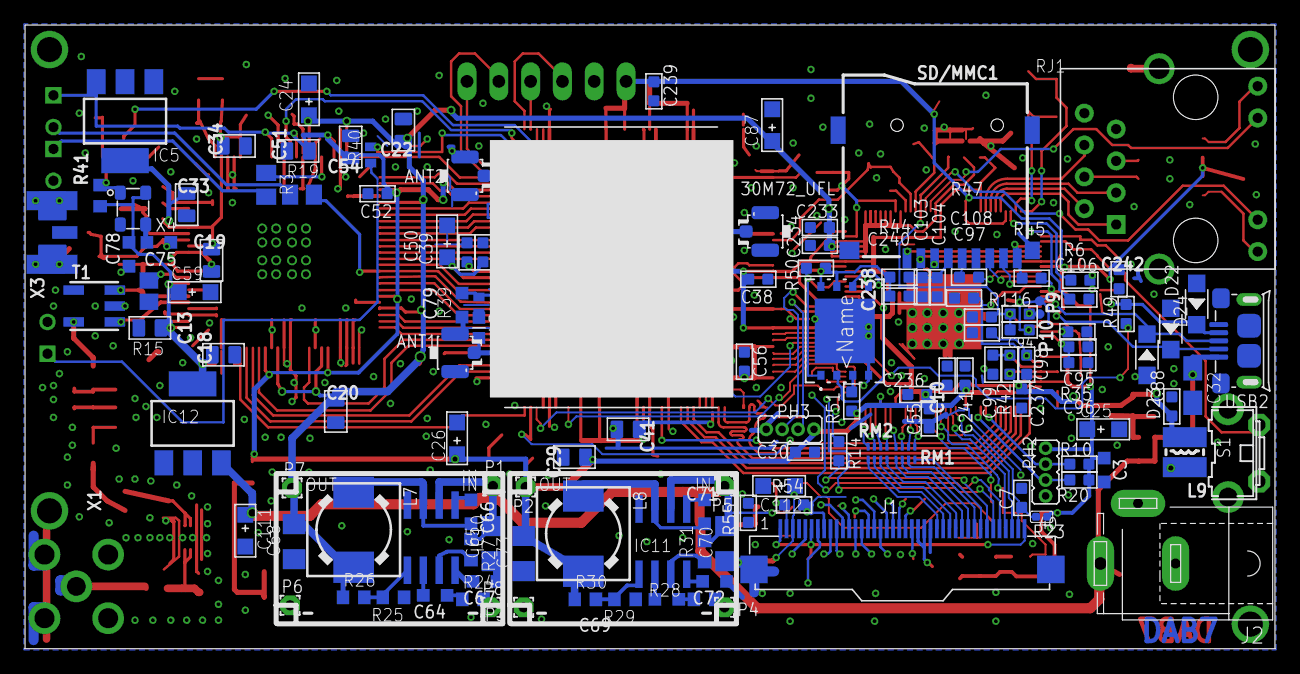
[picture p9: board V3s_LX9_AD9957_gps.brd from below]

Board: 2 copper layers, 99.8 x 49.8 mm, 254 parts (134 on the bottom side), 206 nets.
