KaiBLI/EasyDABv3/(notices)

Notices in the files:
parts and their libraries:
mini-circuits: Copyright (C) 2013, Bob Starr
ad9864: COPYRIGHT: Copyright C 2015 Accelerated Designs. All rights reserved
SparkFun-Aesthetics: Licensing: Creative Commons ShareAlike 4.0 International - https://creativecommons.org/licenses/by-sa/4.0
